epsilonrt/gifam-chip/doc/img/gifam-chip-evb.pdf

R3

7 U1

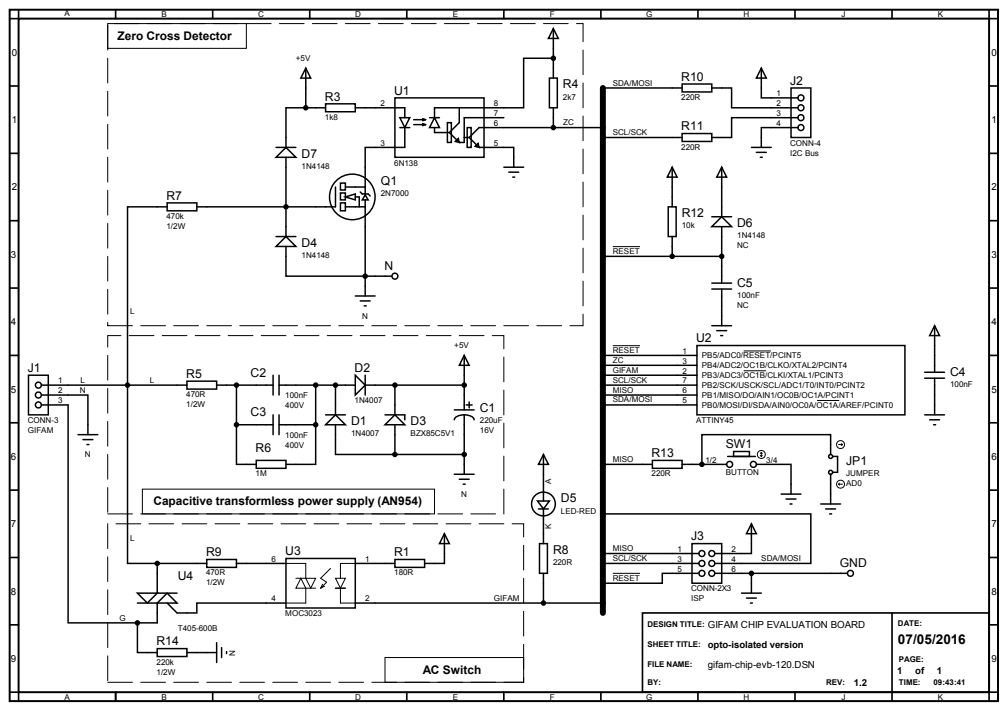
[picture p5: page 1]

Capacitive transformless power supply (AN954)

DESIGN TITLE: GIFAM CHIP EVALUATION BOARD
