epsilonrt/gifam-chip/(list of files, drawings)

Other design files:
hardware/gifam-chip-evb-110.DSN
hardware/gifam-chip-evb-110.LYT
hardware/gifam-chip-evb-120.LYT
hardware/gifam-chip-evb.DSN
hardware/gifam-chip-evb.LYT
hardware/zero-cross-sim-110.DSN
hardware/zero-cross-sim-120.DSN
