epsilonrt/gifam-chip/(commit log)

2016-01-12 Version initiale
    [gifam-chip-evb.DSN, gifam-chip-evb.LYT, zero-cross-sim.DSN]
2016-01-12 Correction schéma en version 1.1
    [gifam-chip-evb.DSN, gifam-chip-evb.LYT, zero-cross-sim.DSN]
2016-01-14 Ajout doc, retrait image et modification des fuse et lock bytes
2016-01-16 Travail en cours Renommage dossier src -> chip Ajout version hardware 1.2 Modification commande opto-triac
    [gifam-chip-evb-110.DSN, gifam-chip-evb-110.LYT, gifam-chip-evb-120.DSN, gifam-chip-evb-120.LYT, gifam-chip-evb.DSN, gifam-chip-evb.LYT, zero-cross-sim-110.DSN, zero-cross-sim-120.DSN]
2016-01-16 Suppression lecture mode GIFAM dans gifam_demo, mise à jour schéma
    [gifam-chip-evb-120.DSN]
2016-01-17 Travail en cours sur doc Déplacement des démonstrations
2016-01-17 Ajout JP1
    [gifam-chip-evb-120.DSN, gifam-chip-evb-120.LYT, zero-cross-sim-120.DSN]
2016-01-17 Travail sur la documentation
2016-01-17 Correction erreur de merge de README.md
2016-04-16 Travail en cours sur bug majeur de détection de zéro
    [config.h]
2016-04-16 Ajout de la gestion de détection du secteur
2016-05-07 Modification des valeurs de R5, C2 et C3 sur la carte d'évaluation
    [gifam-chip-evb-120.DSN, gifam-chip-evb.DSN, gifam-chip-evb.LYT]
